JonahDeClerck/Linear-Pointer/assets/img/20230105_153928.jpg

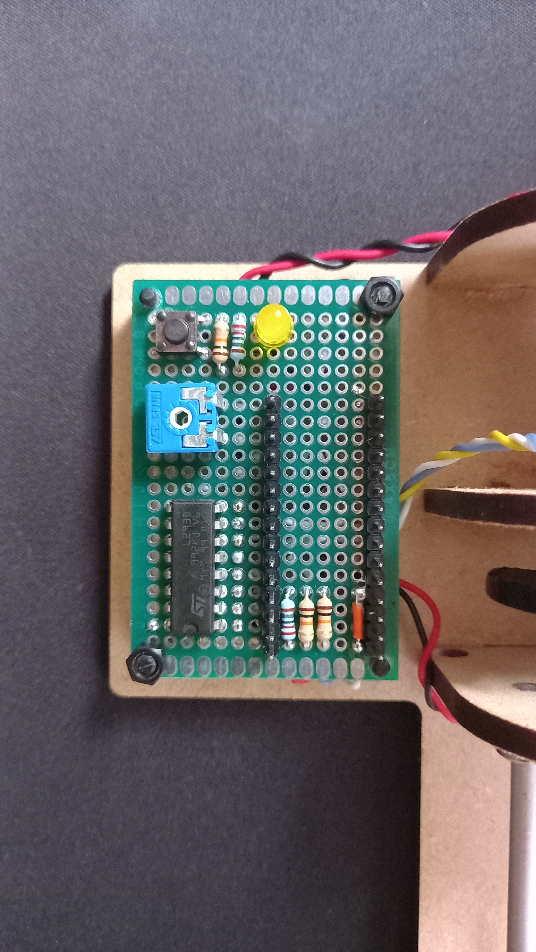
assets/img/20230105_153928.jpg
