JonahDeClerck/Linear-Pointer/assets/img/20230112_222045.jpg

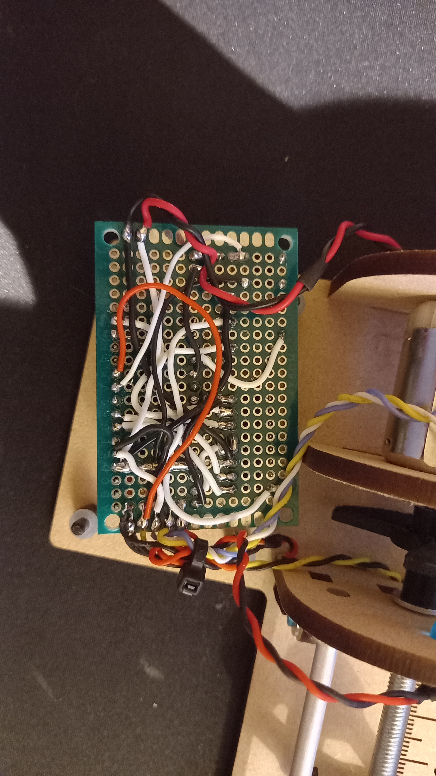
assets/img/20230112_222045.jpg
