JonahDeClerck/Linear-Pointer/README.md

[Google Doc (in dutch)](https://docs.google.com/document/d/1Q0v67J4bvA6itv3k0ROM3XuW2UrELv4ijrkXDc0kQ_o/edit?usp=share_link)
