JonahDeClerck/Linear-Pointer/assets/datasheets/datasheet_dc_motor.png

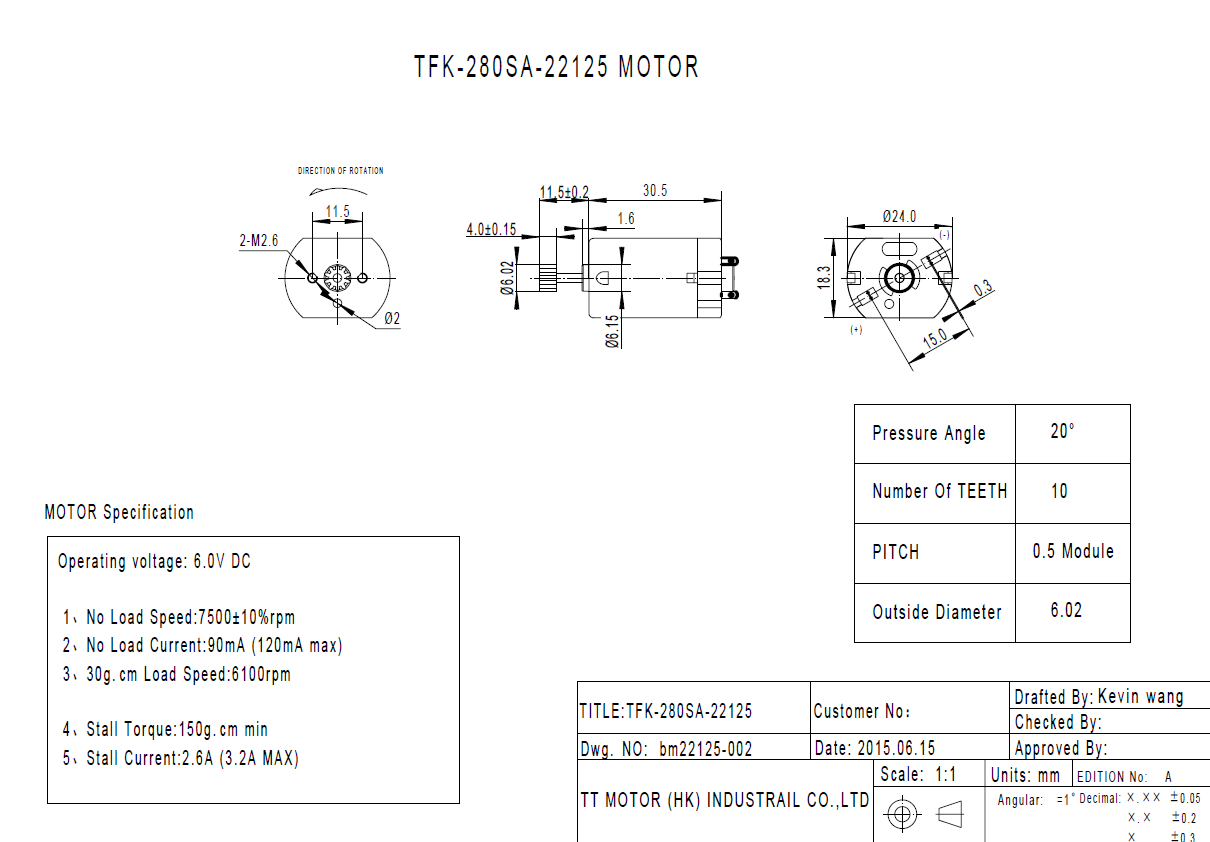
assets/datasheets/datasheet_dc_motor.png
