JonahDeClerck/Linear-Pointer/assets/img/20221223_145929.jpg

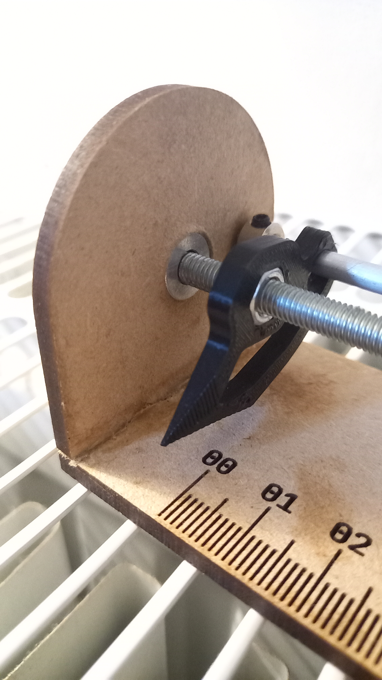
assets/img/20221223_145929.jpg
