JonahDeClerck/Linear-Pointer/assets/img/20230105_154025.jpg

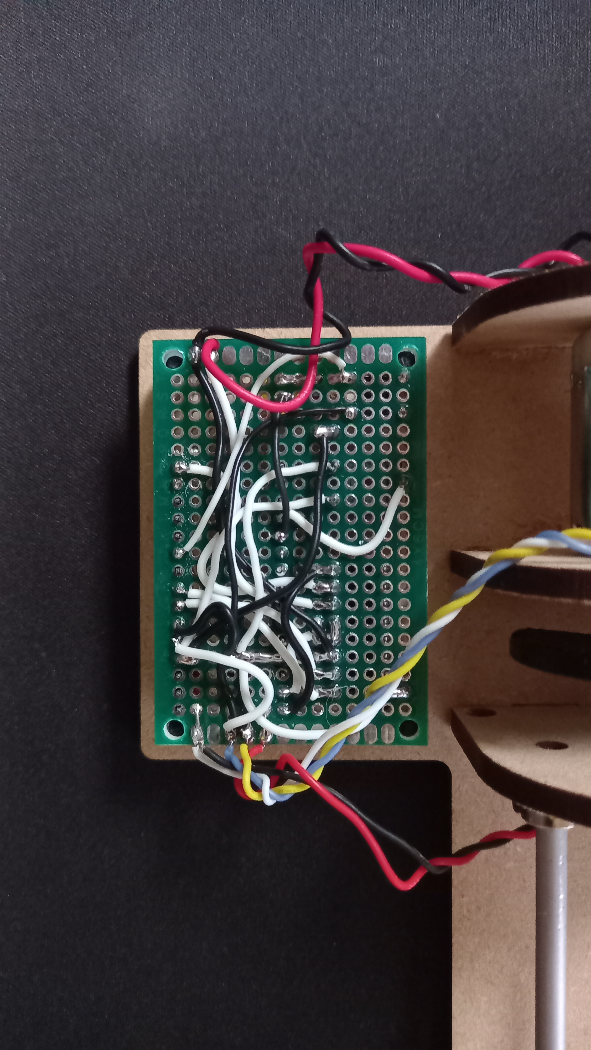
assets/img/20230105_154025.jpg
