JonahDeClerck/Linear-Pointer/assets/img/20230105_154115.jpg

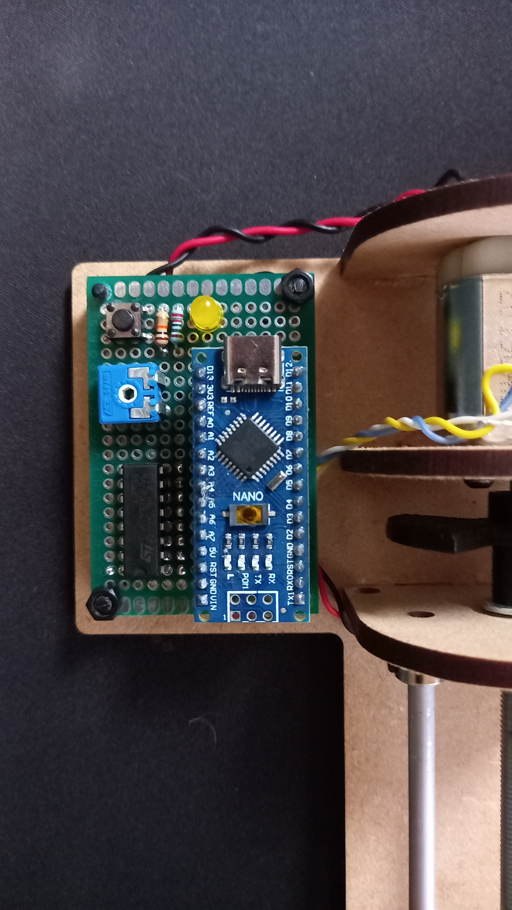
assets/img/20230105_154115.jpg
