JonahDeClerck/Linear-Pointer/assets/img/20230105_154239.jpg

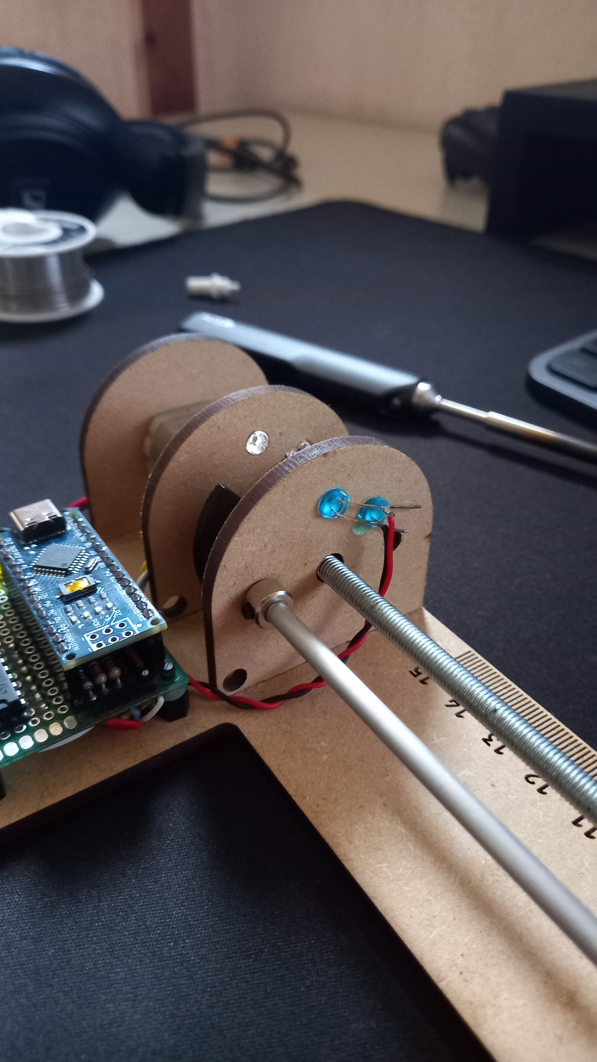
assets/img/20230105_154239.jpg
