JonahDeClerck/Linear-Pointer/assets/img/20230105_154249.jpg

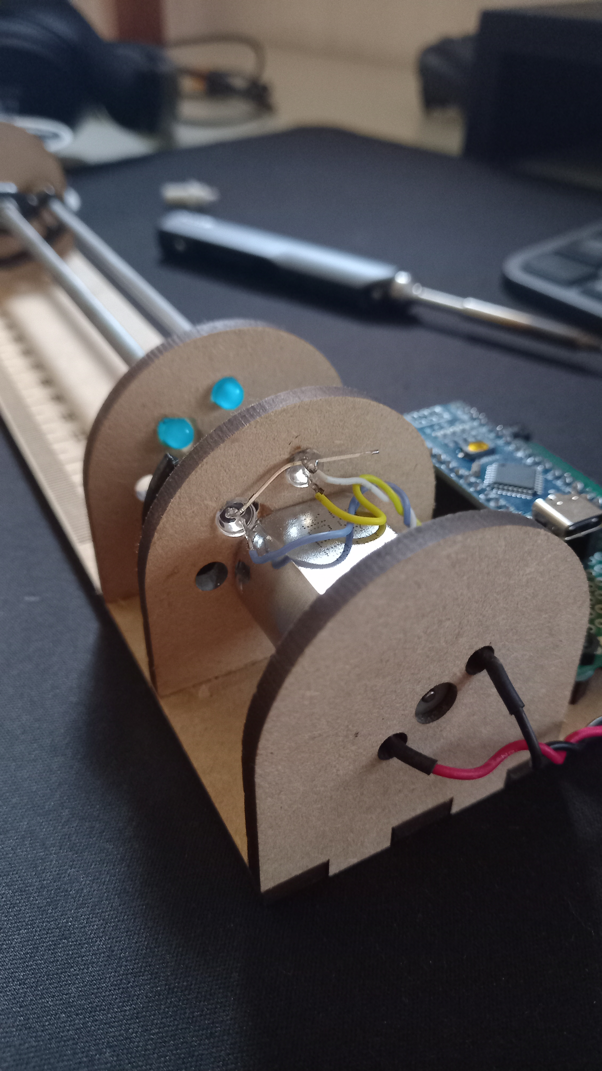
assets/img/20230105_154249.jpg
