JonahDeClerck/Linear-Pointer/assets/img/20230109_163931.jpg

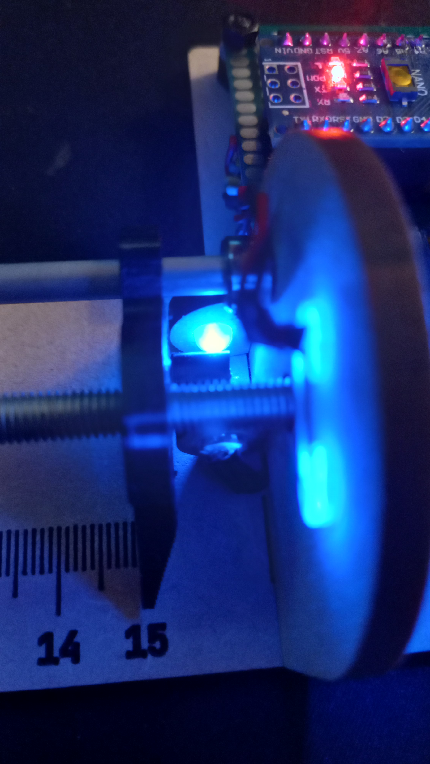
assets/img/20230109_163931.jpg
