JonahDeClerck/Linear-Pointer/assets/img/20230111_171219.jpg

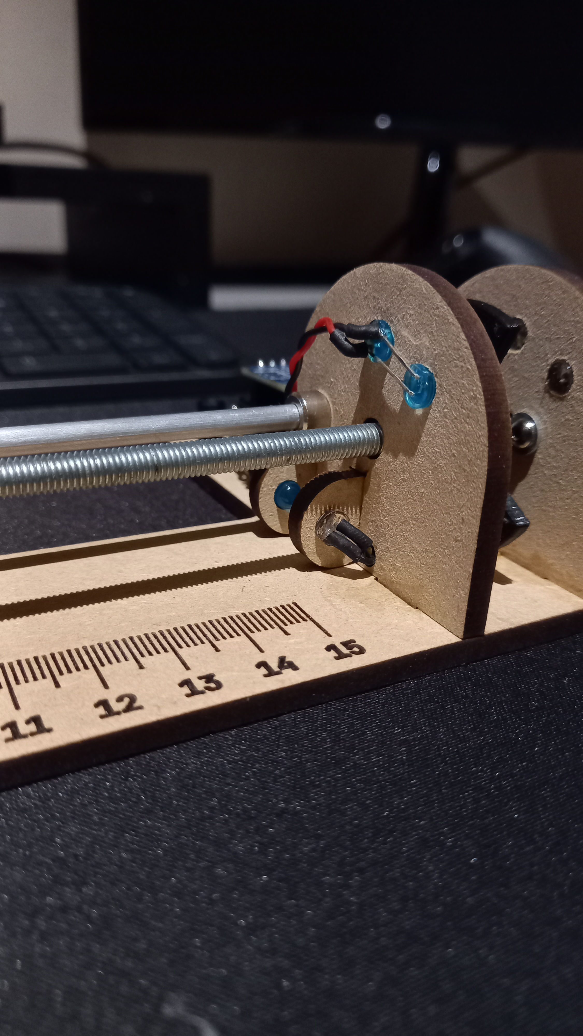
assets/img/20230111_171219.jpg
