JonahDeClerck/Linear-Pointer/assets/img/20230111_171239.jpg

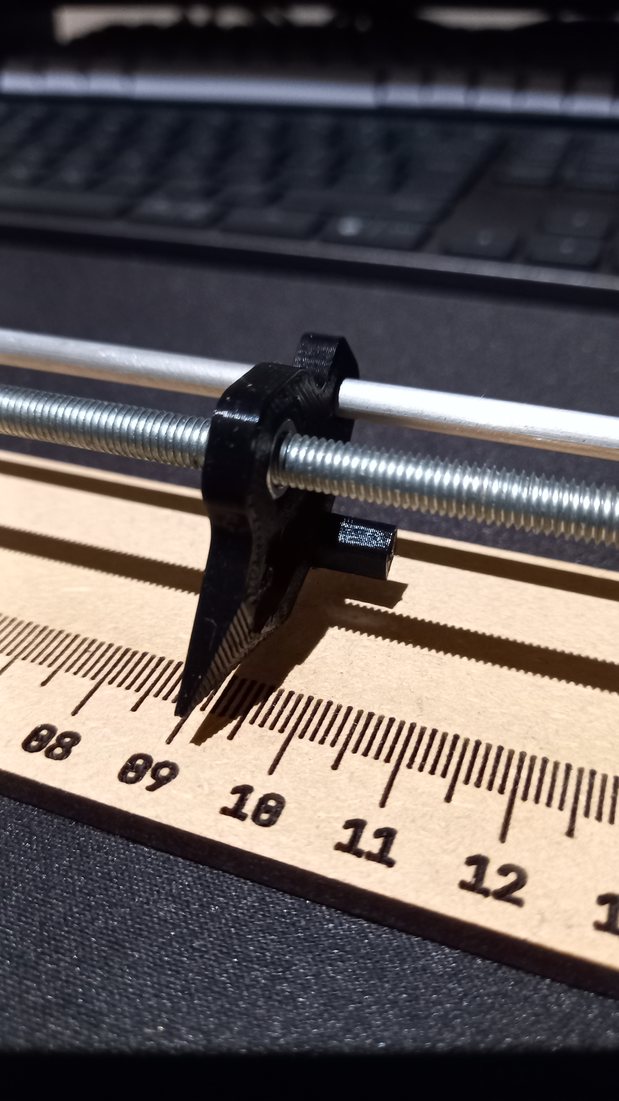
assets/img/20230111_171239.jpg
