JonahDeClerck/Linear-Pointer/assets/img/20230112_221908.jpg

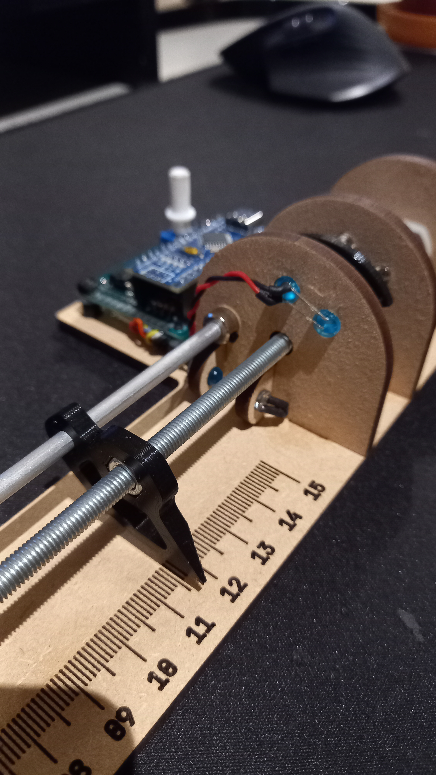
assets/img/20230112_221908.jpg
