JonahDeClerck/Linear-Pointer/assets/img/20230112_221922.jpg

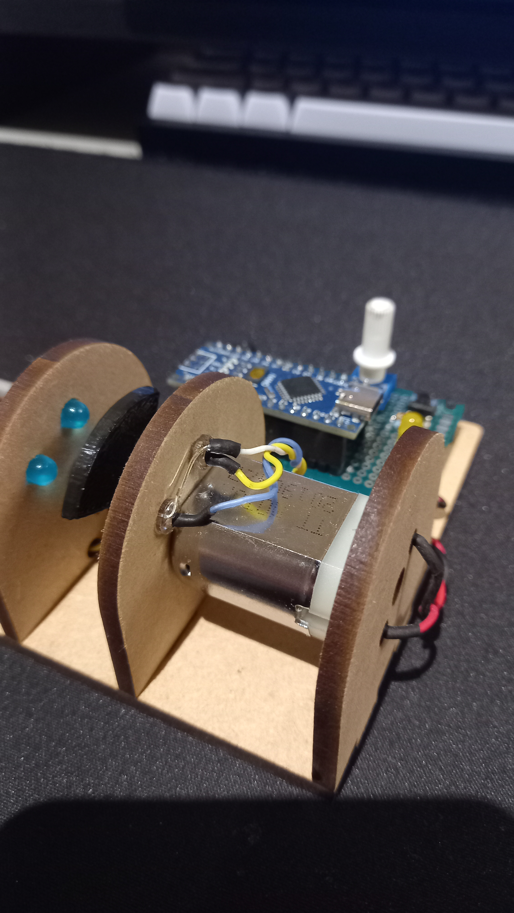
assets/img/20230112_221922.jpg
