JonahDeClerck/Linear-Pointer/assets/img/20230112_221939.jpg

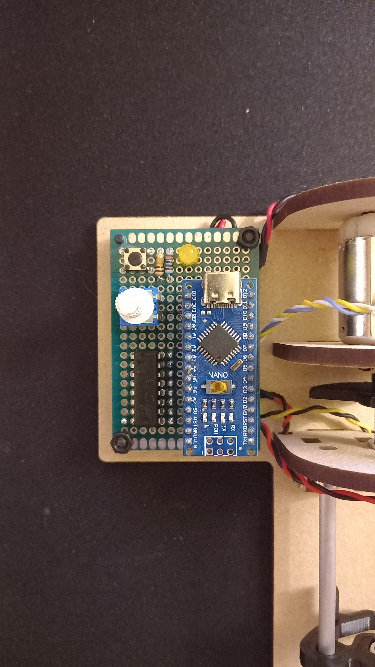
assets/img/20230112_221939.jpg
