JonahDeClerck/Linear-Pointer/assets/img/20230112_222223.jpg

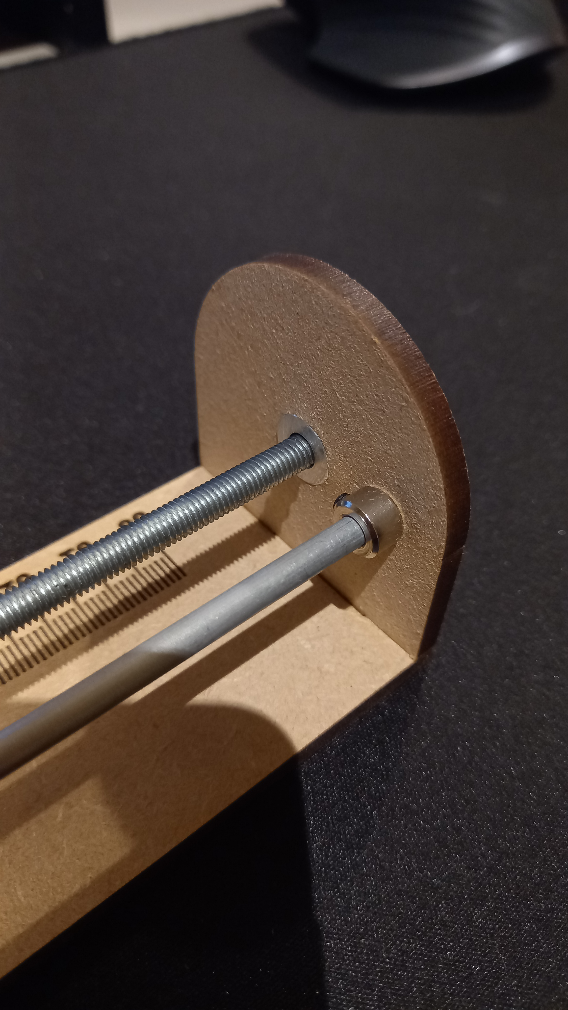
assets/img/20230112_222223.jpg
