JonahDeClerck/Linear-Pointer/assets/img/20230112_222244.jpg

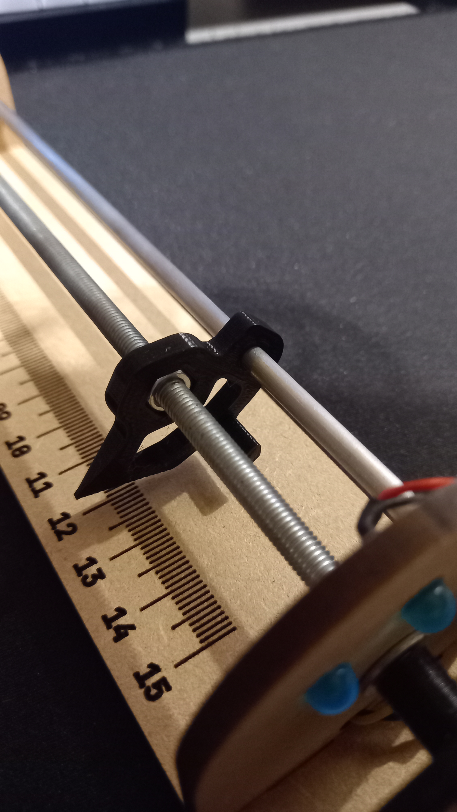
assets/img/20230112_222244.jpg
