JonahDeClerck/Linear-Pointer/assets/img/20230112_222311.jpg

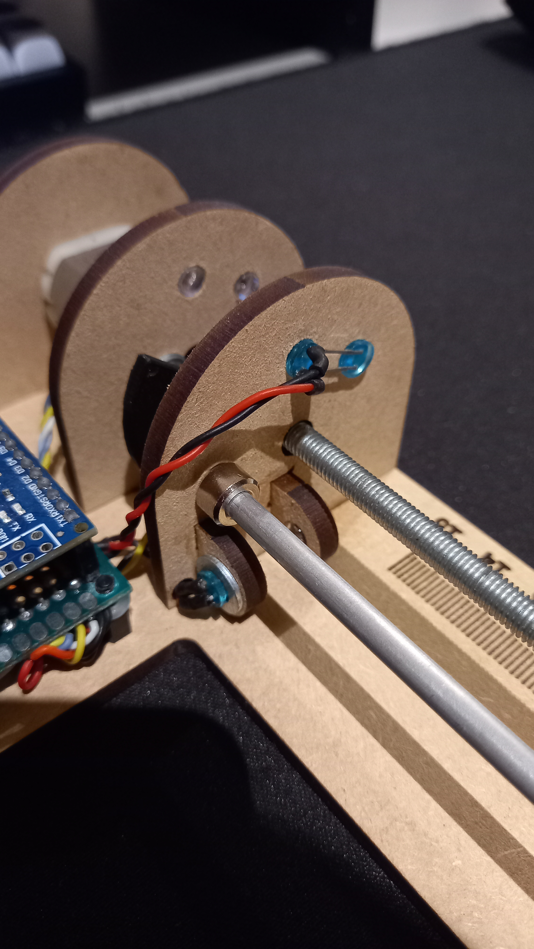
assets/img/20230112_222311.jpg
