JonahDeClerck/Linear-Pointer/assets/img/20230112_222350.jpg

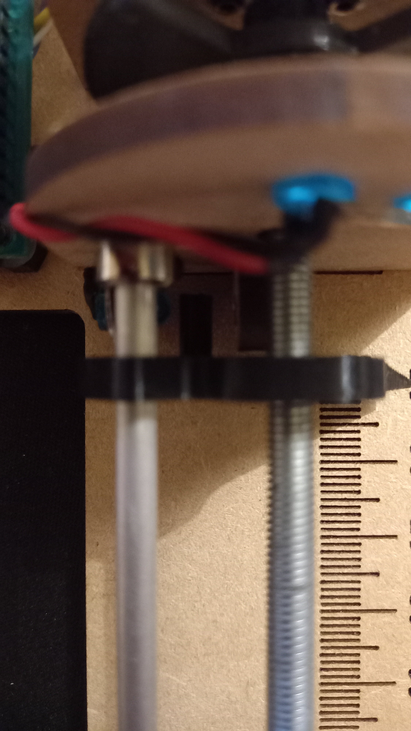
assets/img/20230112_222350.jpg
