JonahDeClerck/Linear-Pointer/assets/img/20230112_222517.jpg

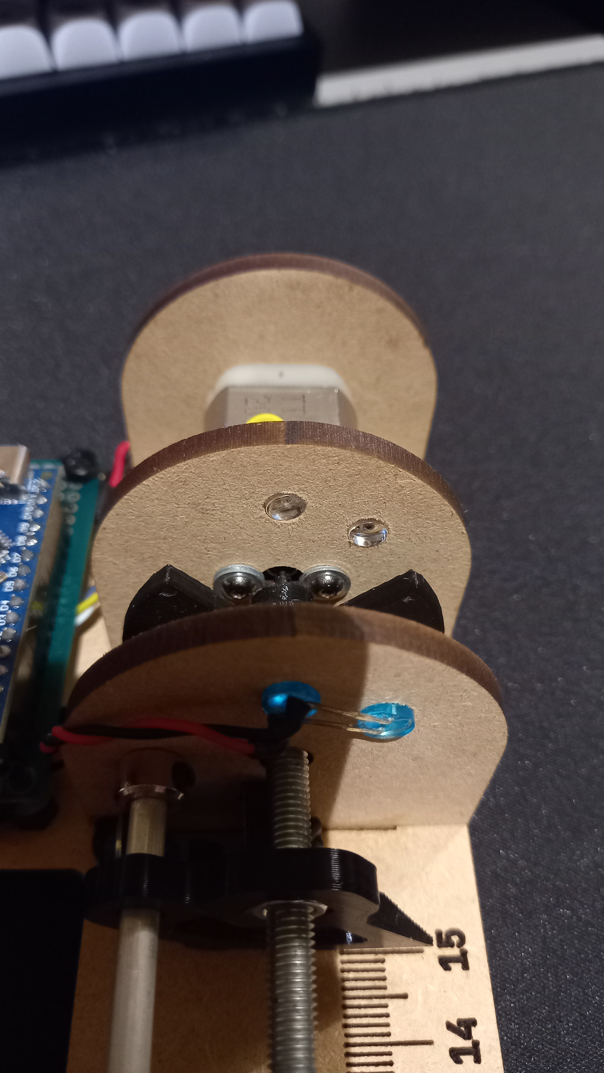
assets/img/20230112_222517.jpg
