JonahDeClerck/Linear-Pointer/assets/img/20230112_222526.jpg

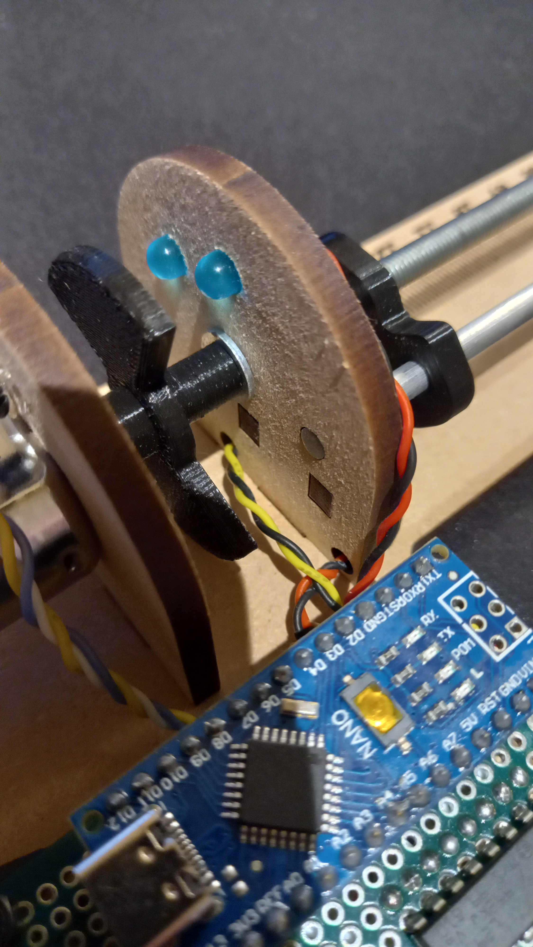
assets/img/20230112_222526.jpg
