JonahDeClerck/Linear-Pointer/assets/img/20230112_222534.jpg

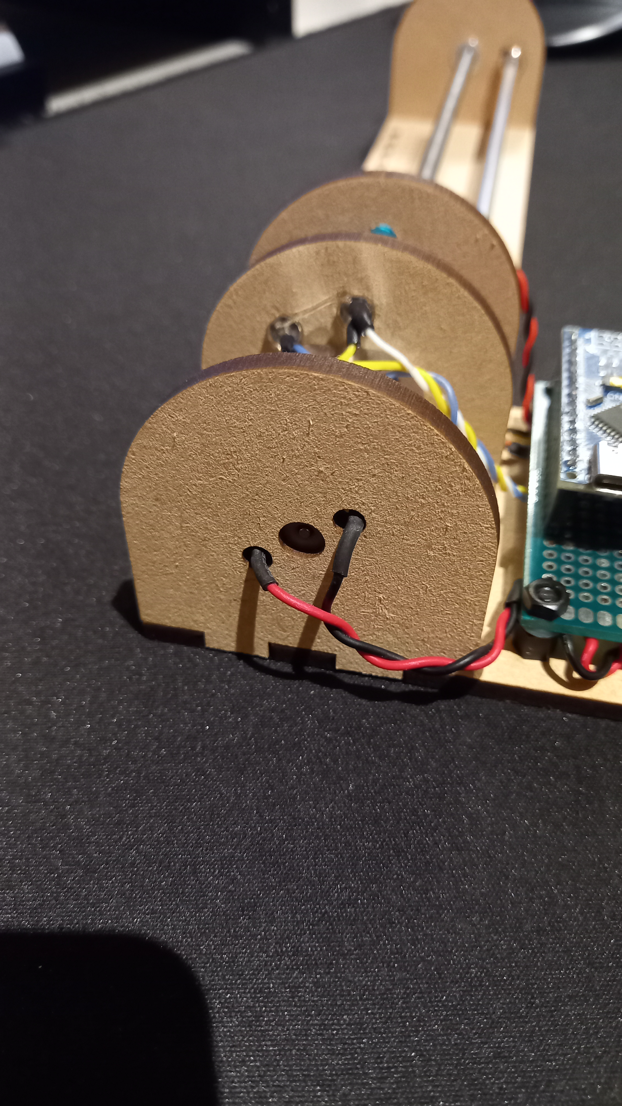
assets/img/20230112_222534.jpg
