JonahDeClerck/Linear-Pointer/assets/img/20230112_222547.jpg

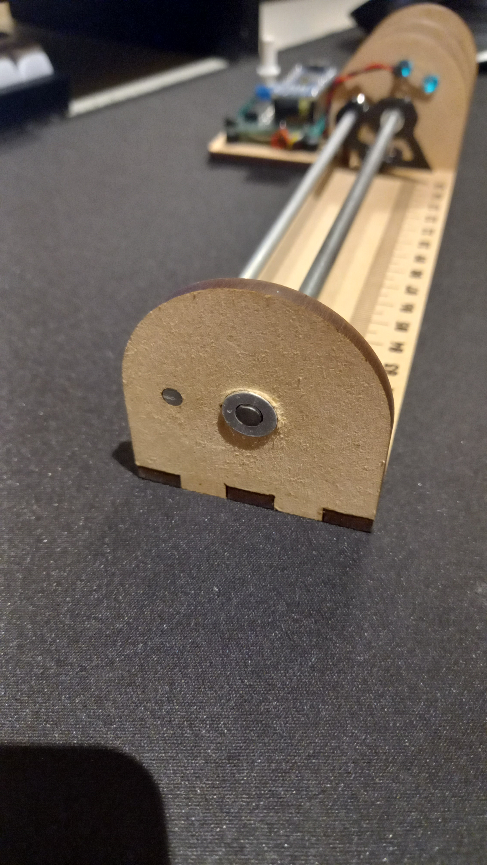
assets/img/20230112_222547.jpg
