JonahDeClerck/Linear-Pointer/assets/img/dc_motor_gear_settings.png

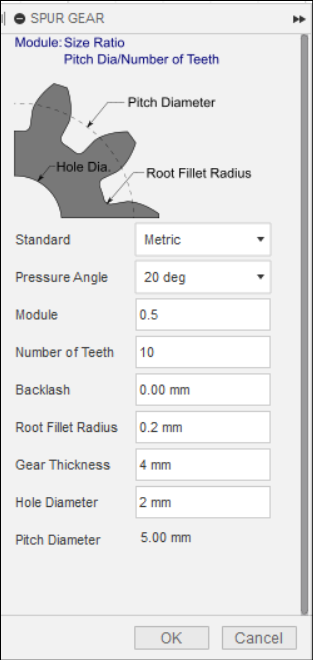
assets/img/dc_motor_gear_settings.png
