JonahDeClerck/Linear-Pointer/assets/img/linear_pointer_02.png

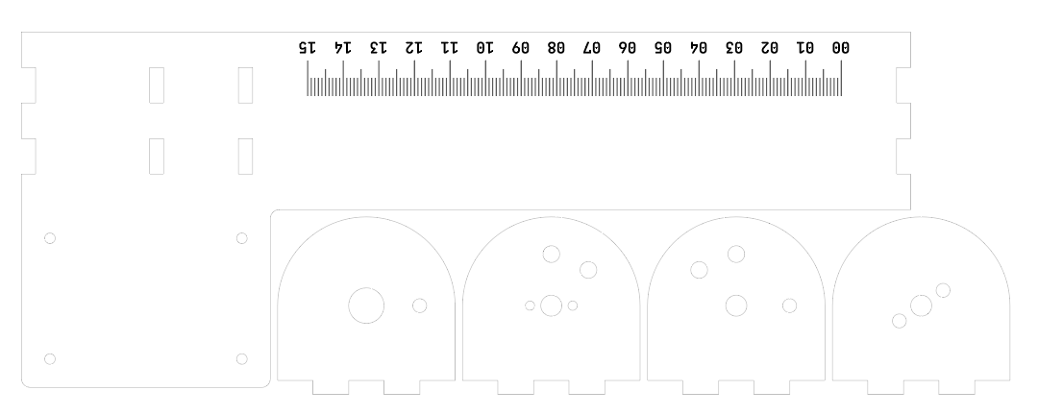
assets/img/linear_pointer_02.png
