JonahDeClerck/Linear-Pointer/assets/img/linear_pointer_calib_02.png

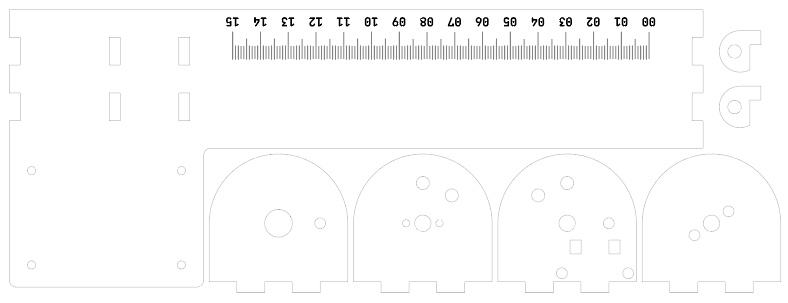
assets/img/linear_pointer_calib_02.png
