JonahDeClerck/Linear-Pointer/assets/img/pointer.png

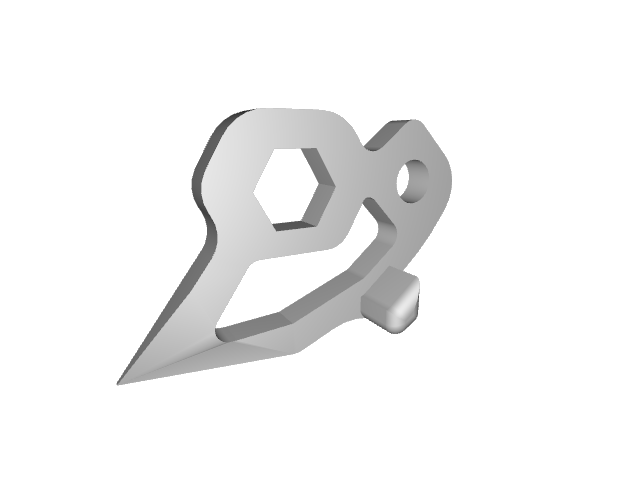
assets/img/pointer.png
