JonahDeClerck/Linear-Pointer/assets/img/schematic_tinkercad.png

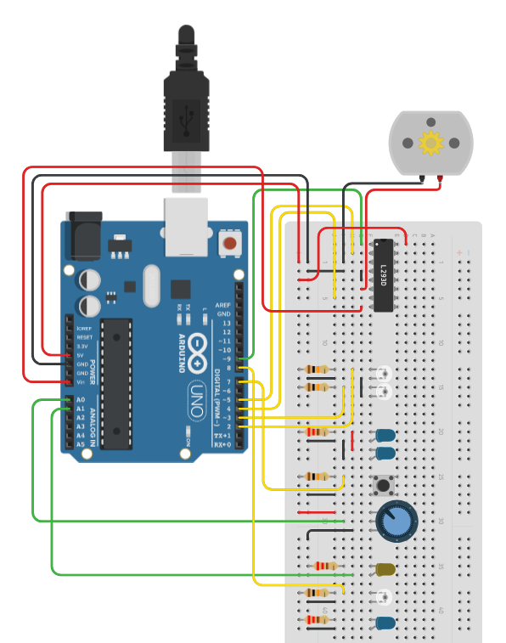
assets/img/schematic_tinkercad.png
