JonahDeClerck/Linear-Pointer/assets/3d-models/pointer.obj

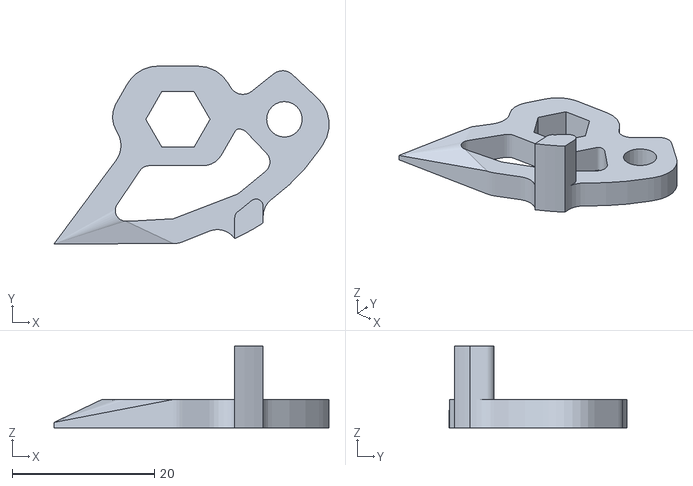
[picture p35: CAD file, 2023-10-04]
assets/3d-models/pointer.obj
38.7 x 25.0 x 11.5
