JonahDeClerck/Linear-Pointer/assets/3d-models/motor-adapter.obj

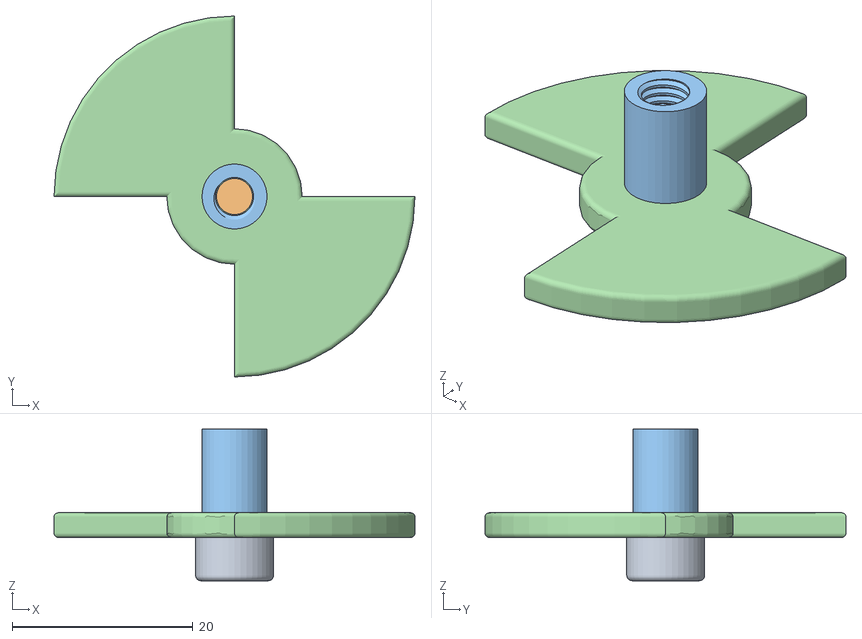
[picture p36: CAD file, 2023-10-04]
assets/3d-models/motor-adapter.obj
40.0 x 40.0 x 16.8
adapter
wheel
